WA2FZW/W8BH-NTP-Clock-Revisited-by-WA2FZW-and-AI6P/Software/NTP_Dual_Clock_Solar_V3.1/Certificate.h

#ifndef	_CERTIFICATE_H_					// Prevent double include
#define	_CERTIFICATE_H_


/*
 *	This is the root SSL certificate for 'hamqsl.com' which we use to
 *	establish a secure connection with the server.
 *
 *	I moved it to a header file as it might have to be changed periodically
 *	when the certicifate is renewed.
 */


const char HQSL_Root_Cert[] PROGMEM = R"CERT(
-----BEGIN CERTIFICATE-----
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
-----END CERTIFICATE-----
)CERT";

#endif
